Yoursel71/ESP32S3_Carrier/output/render_bottom.png

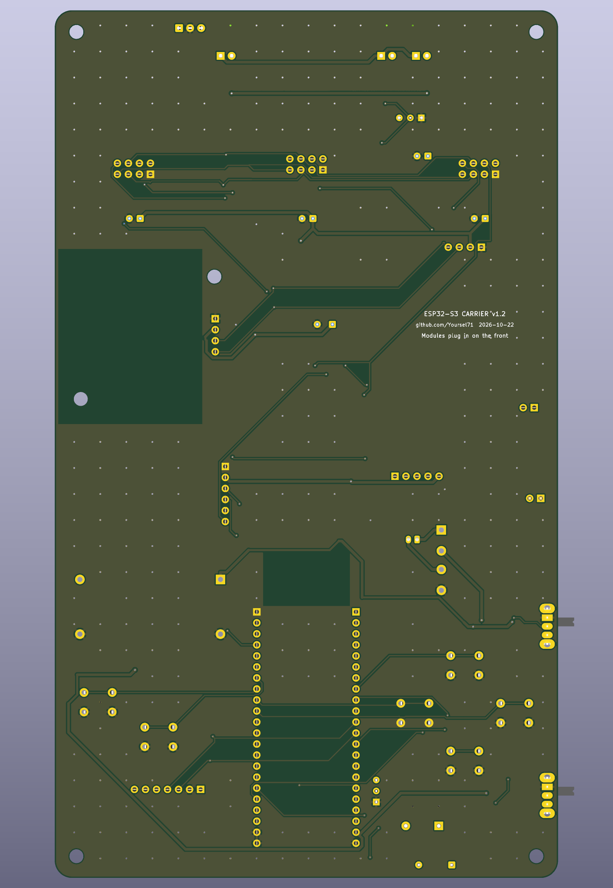
output/render_bottom.png
