Yoursel71/ESP32S3_Carrier/output/render_perspective.png

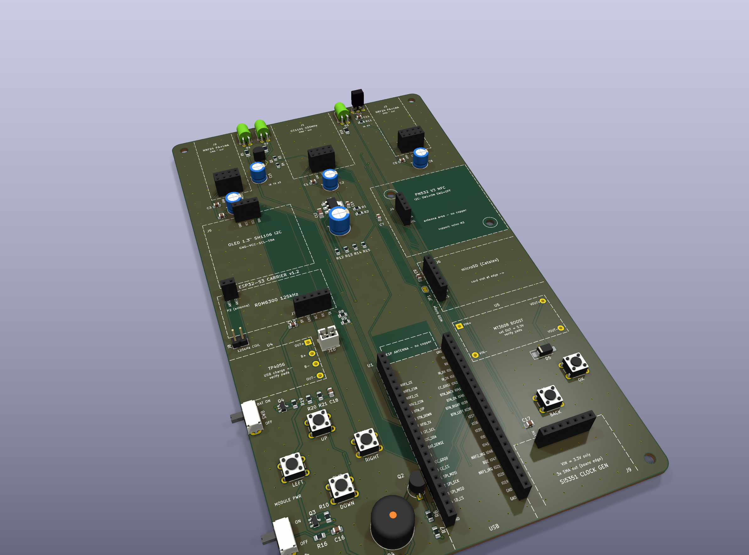
output/render_perspective.png
