Yoursel71/ESP32S3_Carrier/output/BOM.csv

Reference | Value | Footprint | Qty
BZ1 | Passive buzzer | Buzzer_Beeper:Buzzer_12x9.5RM7.6 | 1
C1,C3,C5,C7,C8,C9,C10,C11,C14,C16,C17,C18 | 100nF | Capacitor_SMD:C_0805_2012Metric_Pad1.18x1.45mm_HandSolder | 12
C2,C4,C6,C15 | 100uF | Capacitor_THT:CP_Radial_D6.3mm_P2.50mm | 4
C12 | 10uF | Capacitor_SMD:C_1206_3216Metric_Pad1.33x1.80mm_HandSolder | 1
C13 | 470uF | Capacitor_THT:CP_Radial_D8.0mm_P3.50mm | 1
D1,D2,D3 | IR LED 940nm | LED_THT:LED_D5.0mm_Horizontal_O1.27mm_Z3.0mm | 3
D4 | 1N4148 | Diode_THT:D_DO-35_SOD27_P7.62mm_Horizontal | 1
D5 | SS34 | Diode_SMD:D_SMA_Handsoldering | 1
J1 | CC1101 433MHz SMA | Carrier:CC1101_SMA_2x4_Socket | 1
J2 | NRF24L01+PA+LNA #1 | Carrier:NRF24L01_PA_LNA_Socket | 1
J3 | NRF24L01+PA+LNA #2 | Carrier:NRF24L01_PA_LNA_Socket | 1
J4 | PN532 V3 (I2C) | Carrier:PN532_V3_I2C_Socket | 1
J5 | OLED 1.3in SH1106 I2C | Carrier:OLED_1.3in_I2C_Socket | 1
J6 | Catalex microSD | Carrier:microSD_Catalex_Socket | 1
J7 | RDM6300 125kHz | Carrier:RDM6300_Socket | 1
J8 | 125kHz coil | Connector_PinHeader_2.54mm:PinHeader_1x02_P2.54mm_Vertical | 1
J9 | Si5351 clock gen (3x SMA) | Carrier:Si5351_3SMA_Socket | 1
J10 | 18650 BAT | Connector_JST:JST_PH_B2B-PH-K_1x02_P2.00mm_Vertical | 1
Q1,Q2 | PN2222A | Package_TO_SOT_THT:TO-92_Inline_Wide | 2
Q3,Q4 | AO3401A | Package_TO_SOT_SMD:SOT-23 | 2
R1,R2,R8 | 4.7k | Resistor_SMD:R_0805_2012Metric_Pad1.20x1.40mm_HandSolder | 3
R3 | 220 | Resistor_SMD:R_0805_2012Metric_Pad1.20x1.40mm_HandSolder | 1
R4,R7,R9,R12,R13,R14,R15 | 10k | Resistor_SMD:R_0805_2012Metric_Pad1.20x1.40mm_HandSolder | 7
R5,R17,R18 | 47 | Resistor_SMD:R_1206_3216Metric_Pad1.30x1.75mm_HandSolder | 3
R6 | 1k | Resistor_SMD:R_0805_2012Metric_Pad1.20x1.40mm_HandSolder | 1
R10 | 1M | Resistor_SMD:R_0805_2012Metric_Pad1.20x1.40mm_HandSolder | 1
R11 | 100 | Resistor_SMD:R_0805_2012Metric_Pad1.20x1.40mm_HandSolder | 1
R16,R19,R20,R21 | 100k | Resistor_SMD:R_0805_2012Metric_Pad1.20x1.40mm_HandSolder | 4
SW1 | UP | Button_Switch_THT:SW_PUSH_6mm | 1
SW2 | DOWN | Button_Switch_THT:SW_PUSH_6mm | 1
SW3 | LEFT | Button_Switch_THT:SW_PUSH_6mm | 1
SW4 | RIGHT | Button_Switch_THT:SW_PUSH_6mm | 1
SW5 | OK | Button_Switch_THT:SW_PUSH_6mm | 1
SW6 | BACK | Button_Switch_THT:SW_PUSH_6mm | 1
SW7 | MODULE PWR | Button_Switch_THT:SW_Slide_SPDT_Angled_CK_OS102011MA1Q | 1
SW8 | MAIN PWR | Button_Switch_THT:SW_Slide_SPDT_Angled_CK_OS102011MA1Q | 1
U1 | ESP32-S3-DevKitC-1 N16R8 | Carrier:ESP32-S3-DevKitC-1_Socket | 1
U2 | AMS1117-3.3 | Package_TO_SOT_SMD:SOT-223-3_TabPin2 | 1
U3 | VS1838B | OptoDevice:Vishay_MINICAST-3Pin | 1
U4 | TP4056 module (protected) | Carrier:TP4056_Module_Pads | 1
U5 | MT3608 boost module (set 5.3V) | Carrier:MT3608_Module_Pads | 1
