Yoursel71/ESP32S3_Carrier/output/assembly_1to1.pdf

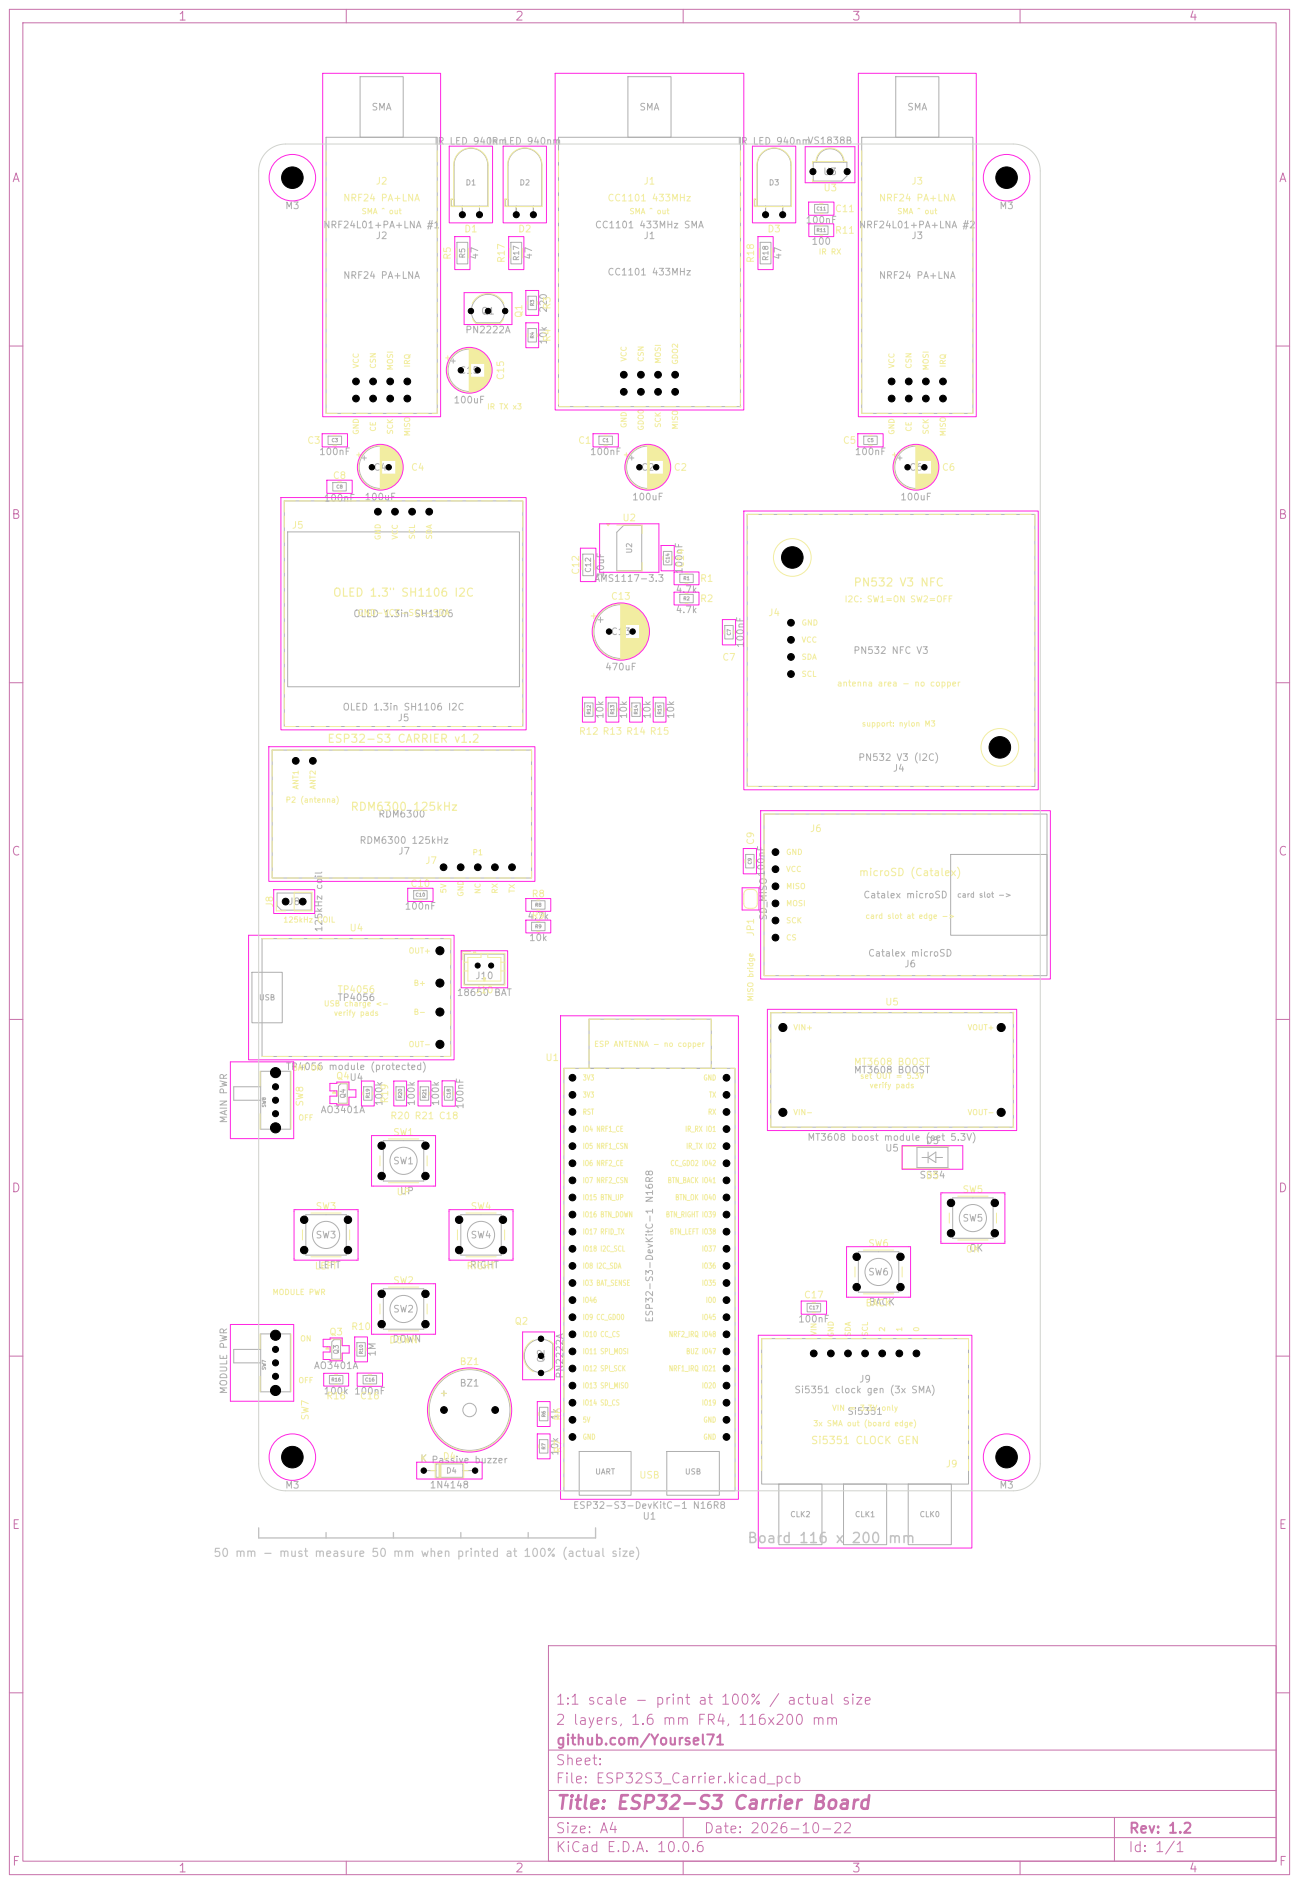
[picture p4: page 1]

IR RX MISO bridge
USB 10k R4 100uF C4

ESP ANTENNA - no copper USB

GND
VCC MISO MOSI SCK

MODULE PWR OFF ON

R16 50 mm - must measure 50 mm when printed at 100% (actual size)

1:1 scale - print at 100% / actual size
2 layers, 1.6 mm FR4, 116x200 mm
github.com/Yoursel71
Sheet:
File: ESP32S3_Carrier.kicad_pcb
Title: ESP32-S3 Carrier Board

Size: A4 | Rev: 1.2
KiCad E.D.A. 10.0.6 | Id: 1/1
