Yoursel71/ESP32S3_Carrier/output/schematic.pdf

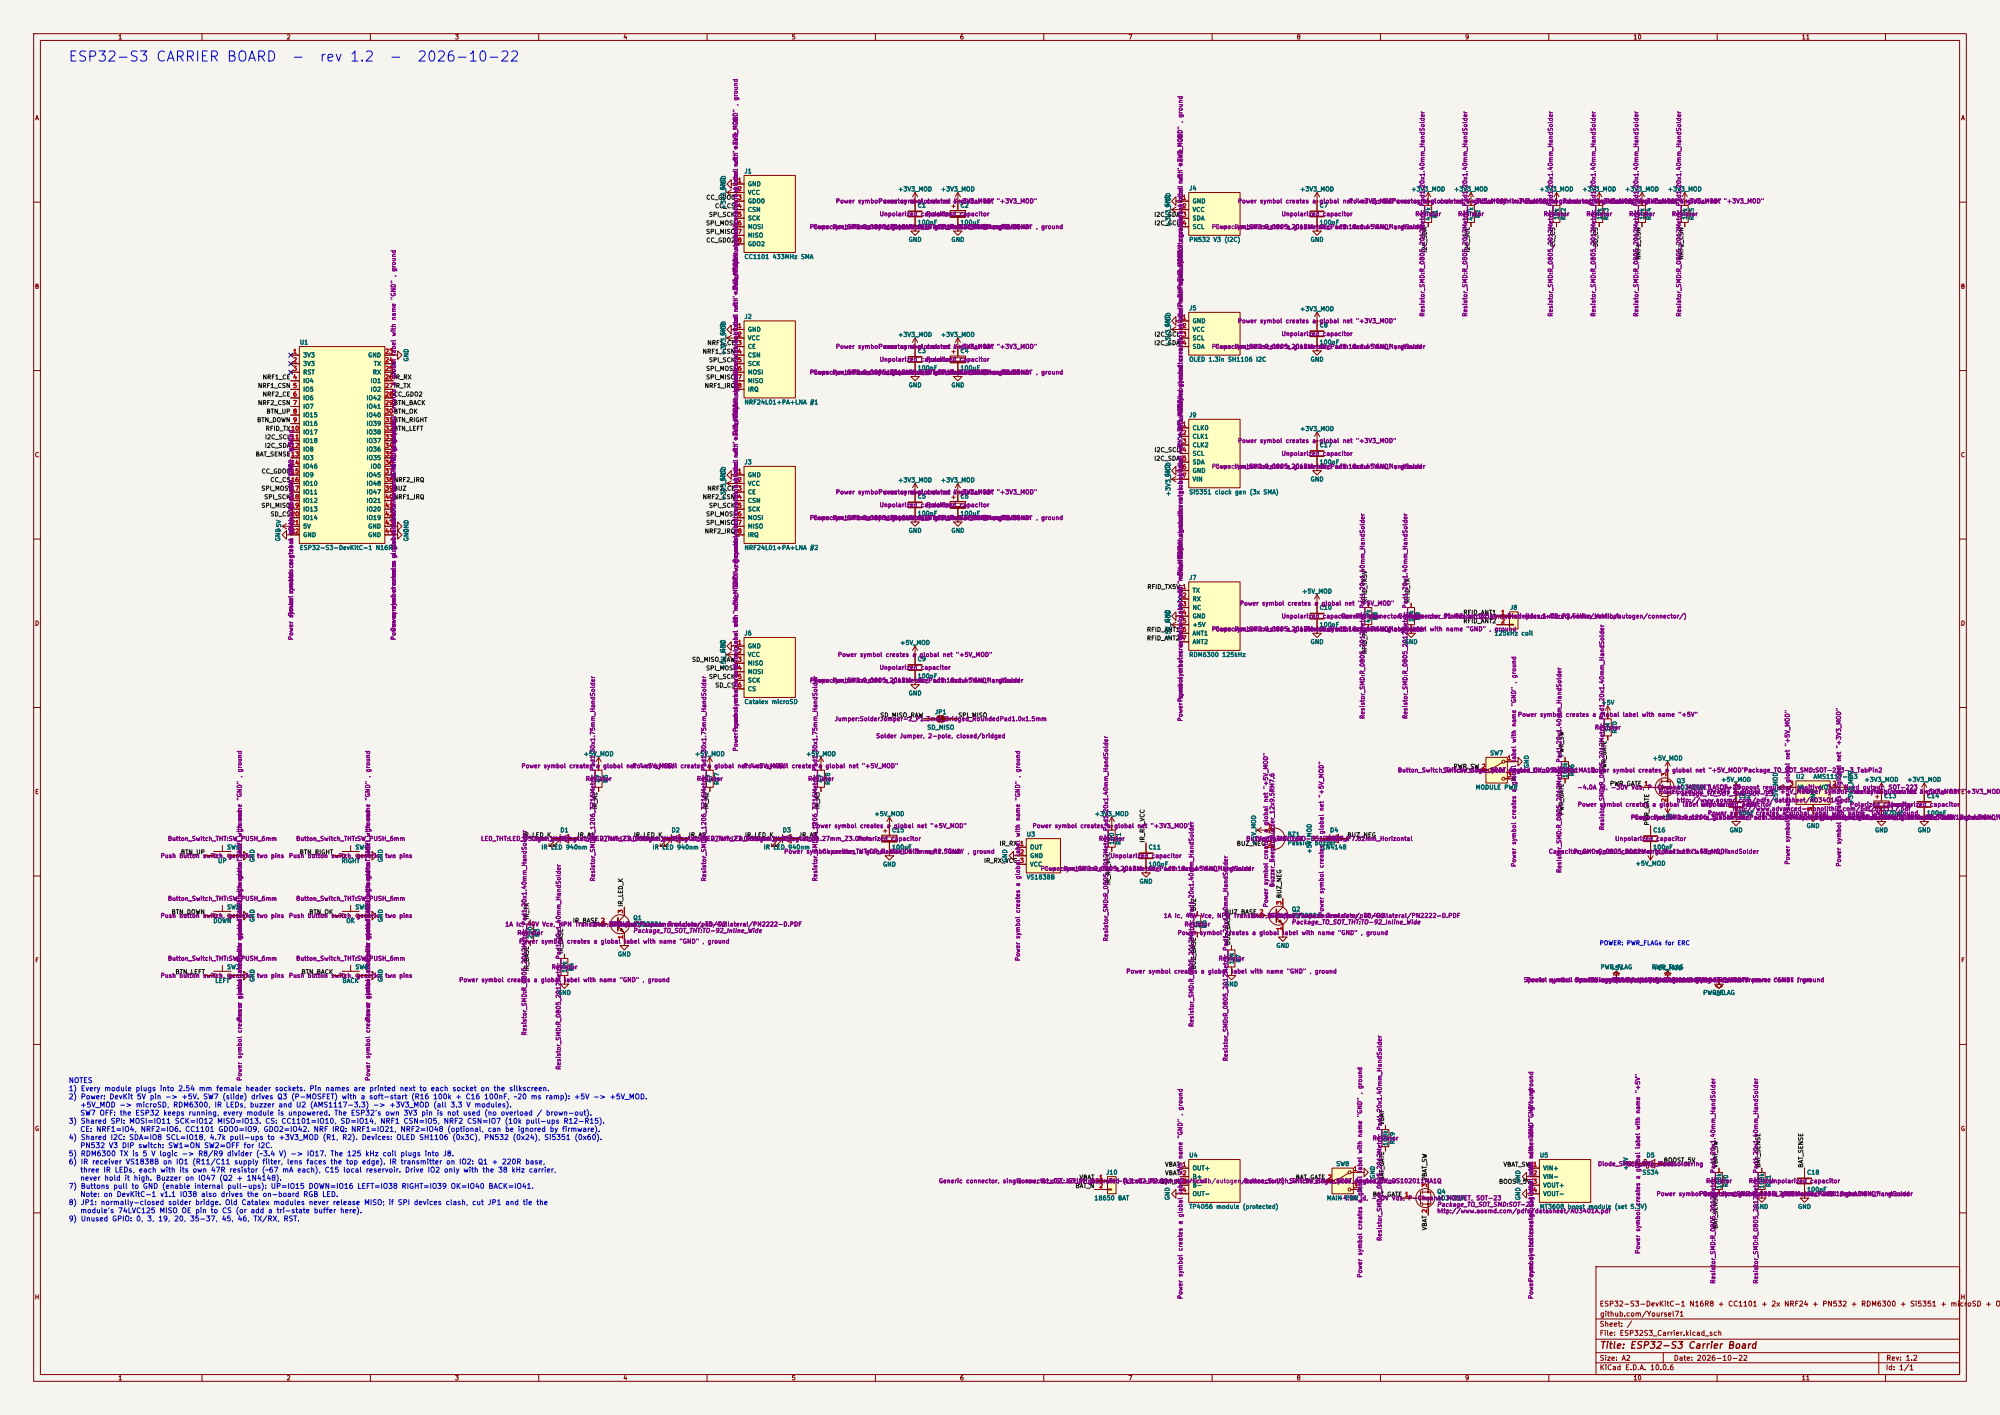
[picture p5: page 1]

IRQ 8 +3V3_MOD Power symbol creates a global net "+3V3_MOD" GND Power symbol creates a global label with name "GND" , ground

J4PN532 V3 (I2C) +3V3_MOD Power symbol creates a global net "+3V3_MOD" GND Power symbol creates a global label with name "GND" , ground GND Power symbol creates a global label with name "GND" , ground

IR_A3 IR_A3 CC_CS CC_GDO0 NRF2_CE SD_CS NRF2_CSN
Push button switch, generic, two pinsGND Power symbol creates a global label with name "GND" , ground 3V3 1

Power symbol creates a global label with name "GND" , ground +3V3_MOD
Power symbol creates a global label with name "GND" , ground C1

Power symbol creates a global net "+3V3_MOD" +3V3_MOD

+3V3_MOD
Power symbol creates a global net "+3V3_MOD"

VCC 2
SDA 3
Power symbol creates a global label with name "GND" , ground GND Power symbol creates a global label with name "GND" , ground
SCL 4

100nF Capacitor_SMD:C_0805_2012Metric_Pad1.18x1.45mm_HandSolder
Power symbol creates a global label with name "GND" , ground C3

Power symbol creates a global label with name "GND" , ground C8

3 GND Power symbol creates a global label with name "GND" , ground U1

J5OLED 1.3in SH1106 I2C
GND 1
SCL 3
SDA 4

I2C_SDA SPI_MISO

Power symbol creates a global label with name "GND" , ground C4

Power symbol creates a global label with name "GND" , ground GND

Si5351 clock gen (3x SMA) GND Power symbol creates a global label with name "GND" , ground +3V3_MOD Power symbol creates a global net "+3V3_MOD"

Power symbol creates a global label with name "GND" , ground

Power symbol creates a global label with name "GND" , ground 1

Power symbol creates a global net "+5V_MOD" GND

Solder Jumper, 2-pole, closed/bridged R18 47 Resistor_SMD:R_1206_3216Metric_Pad1.30x1.75mm_HandSolder Resistor D3

http://www.aosmd.com/pdfs/datasheet/AO3401A.pdf -4.0A Id, -30V Vds, P-Channel MOSFET, SOT-23 +5V_MOD
Power symbol creates a global net "+5V_MOD" C16

Power symbol creates a global net "+5V_MOD"

Power symbol creates a global net "+5V_MOD"D2

Power symbol creates a global net "+5V_MOD"C15

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

Power symbol creates a global label with name "GND" , ground Q3

Unpolarized capacitor +5V_MOD
Power symbol creates a global label with name "GND" , ground C13

Button_Switch_THT:SW_PUSH_6mm
Push button switch, generic, two pins SW1 UP
BTN_UP

SW4 RIGHT Button_Switch_THT:SW_PUSH_6mm
BTN_RIGHT
Push button switch, generic, two pins SW5 OK

IR LED 940nm

Push button switch, generic, two pins SW2 DOWN

3 Q2PN2222A Package_TO_SOT_THT:TO-92_Inline_Wide 1A Ic, 40V Vce, NPN Transistor, 1=E 2=B NPN General https://www.onsemi.com/pub/Collateral/PN2222-D.PDF 3=CPurpose Transistor, TO-92

3 Q1PN2222A Package_TO_SOT_THT:TO-92_Inline_Wide 1A Ic, 40V Vce, NPN Transistor, 1=E 2=B NPN General https://www.onsemi.com/pub/Collateral/PN2222-D.PDF 3=CPurpose Transistor, TO-92 GND

Power symbol creates a global label with name "GND" , ground SW3

Power symbol creates a global label with name "GND" , ground +5V Power symbol creates a global label with name "+5V" PWR_FLAG
Special symbol for telling ERC where power comes from

Power symbol creates a global net "+5V_MOD" PWR_FLAG
SS34 Diode_SMD:D_SMA_Handsoldering Schottky diode +5V_MOD

NOTES
1) Every module plugs into 2.54 mm female header sockets. Pin names are printed next to each socket on the silkscreen.
2) Power: DevKit 5V pin -> +5V. SW7 (slide) drives Q3 (P-MOSFET) with a soft-start (R16 100k + C16 100nF, ~20 ms ramp): +5V -> +5V_MOD.
+5V_MOD -> microSD, RDM6300, IR LEDs, buzzer and U2 (AMS1117-3.3) -> +3V3_MOD (all 3.3 V modules).
SW7 OFF: the ESP32 keeps running, every module is unpowered. The ESP32's own 3V3 pin is not used (no overload / brown-out). 3) Shared SPI: MOSI=IO11 SCK=IO12 MISO=IO13. CS: CC1101=IO10, SD=IO14, NRF1 CSN=IO5, NRF2 CSN=IO7 (10k pull-ups R12-R15).

CE: NRF1=IO4, NRF2=IO6. CC1101 GDO0=IO9, GDO2=IO42. NRF IRQ: NRF1=IO21, NRF2=IO48 (optional, can be ignored by firmware). 4) Shared I2C: SDA=IO8 SCL=IO18, 4.7k pull-ups to +3V3_MOD (R1, R2). Devices: OLED SH1106 (0x3C), PN532 (0x24), Si5351 (0x60).

PN532 V3 DIP switch: SW1=ON SW2=OFF for I2C.
5) RDM6300 TX is 5 V logic -> R8/R9 divider (~3.4 V) -> IO17. The 125 kHz coil plugs into J8.
6) IR receiver VS1838B on IO1 (R11/C11 supply filter, lens faces the top edge). IR transmitter on IO2: Q1 + 220R base,
three IR LEDs, each with its own 47R resistor (~67 mA each), C15 local reservoir. Drive IO2 only with the 38 kHz carrier, never hold it high. Buzzer on IO47 (Q2 + 1N4148). 7) Buttons pull to GND (enable internal pull-ups): UP=IO15 DOWN=IO16 LEFT=IO38 RIGHT=IO39 OK=IO40 BACK=IO41.

2 3 U5MT3608 boost module (set 5.3V) VIN+

18650 BAT Generic connector, single Connector_JST:JST_PH_B2B-PH-K_1x02_P2.00mm_Vertical row, 01x02, script generated (kicad-library-utils/schlib/autogen/connector/) 1

Power symbol creates a global label with name "GND" , ground C18

Note: on DevKitC-1 v1.1 IO38 also drives the on-board RGB LED.
8) JP1: normally-closed solder bridge. Old Catalex modules never release MISO; if SPI devices clash, cut JP1 and tie the

Size: A2 | Rev: 1.2
KiCad E.D.A. 10.0.6 | Id: 1/1
