Yoursel71/ESP32S3_Carrier/output/copper_layers_1to1.pdf

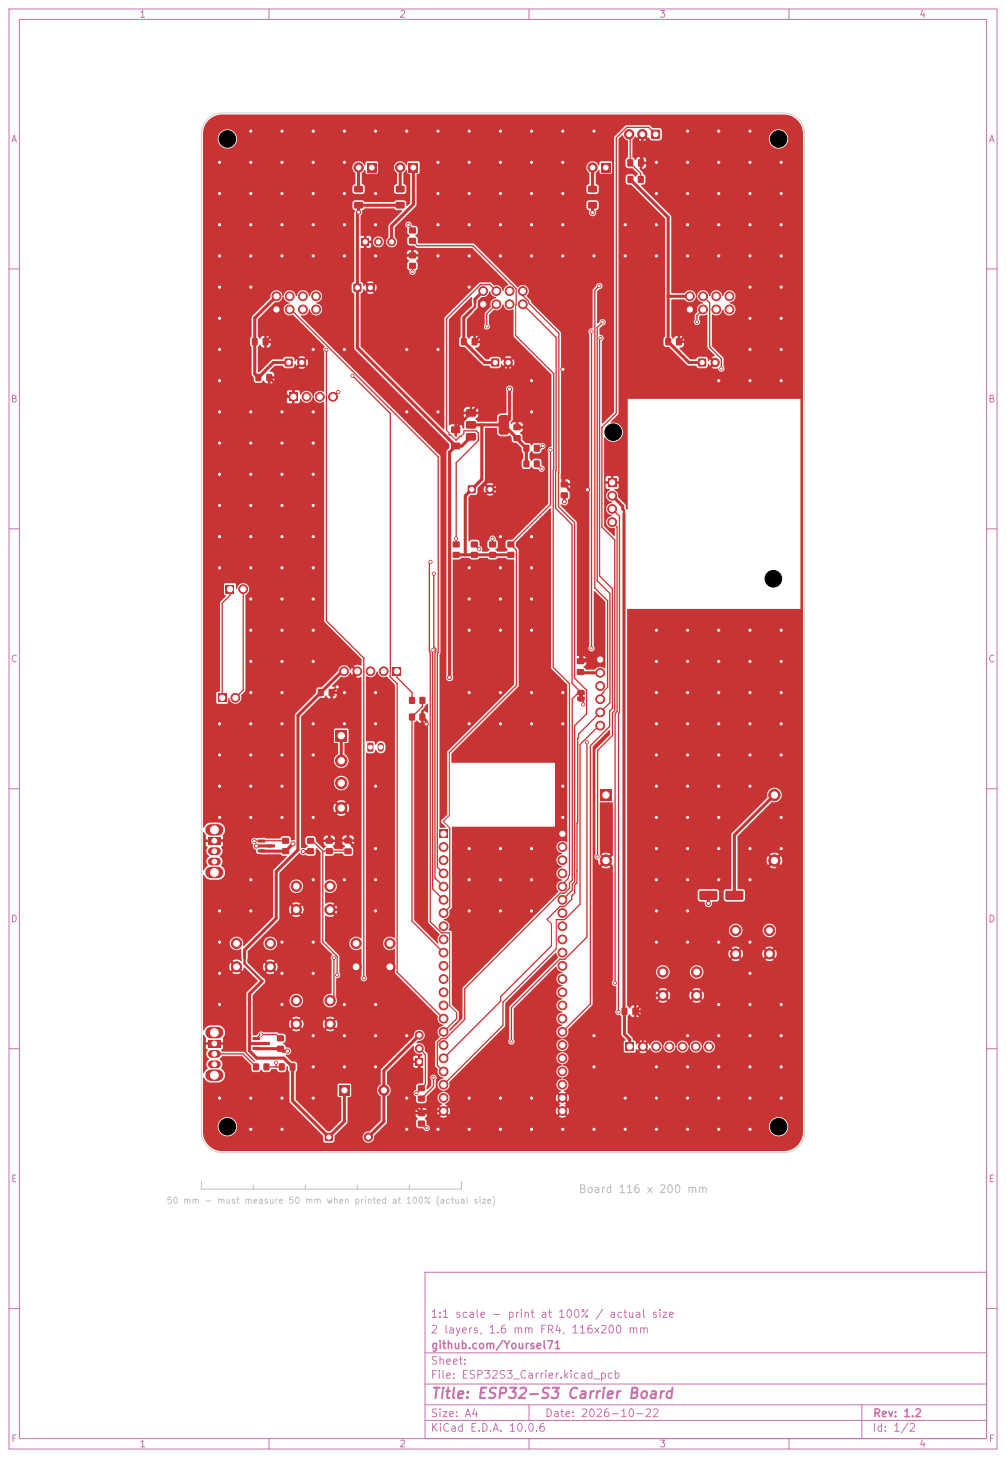
[picture p6: page 1]

50 mm - must measure 50 mm when printed at 100% (actual size)

1:1 scale - print at 100% / actual size
2 layers, 1.6 mm FR4, 116x200 mm
github.com/Yoursel71
Sheet:
File: ESP32S3_Carrier.kicad_pcb
Title: ESP32-S3 Carrier Board

Size: A4 | Rev: 1.2 | F Date: 2026-10-22
KiCad E.D.A. 10.0.6 | Id: 1/2

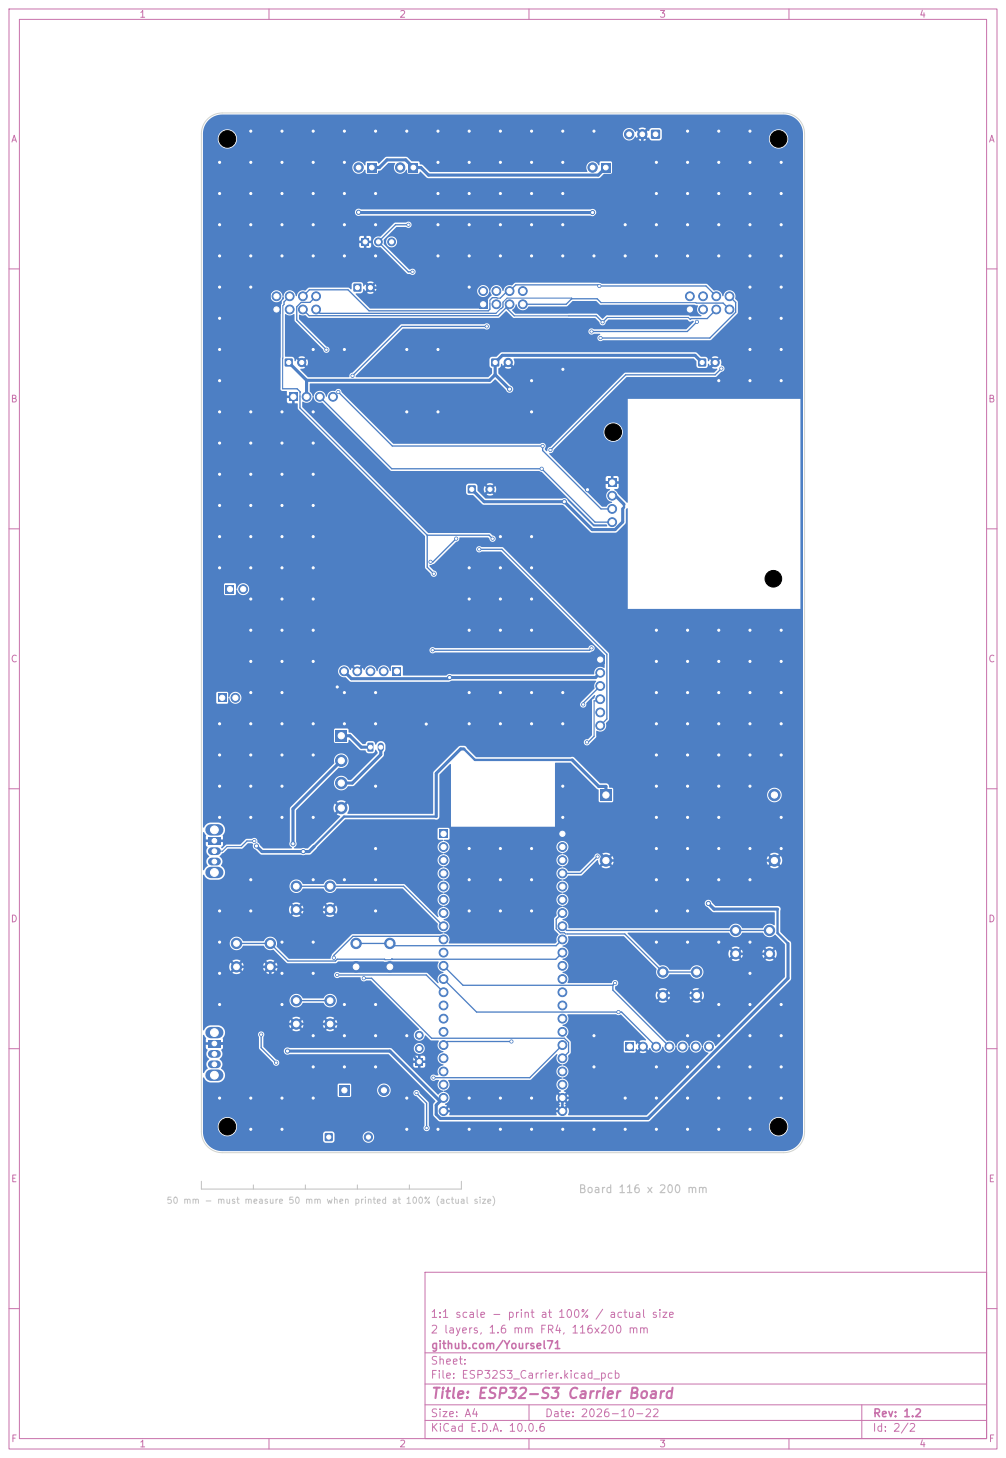
[picture p7: page 2]

50 mm - must measure 50 mm when printed at 100% (actual size)

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

Size: A4 | Rev: 1.2 | F Date: 2026-10-22
KiCad E.D.A. 10.0.6 | Id: 2/2
