Yoursel71/ESP32S3_Carrier/(list of files, drawings)

Other design files:
scripts/_route.dsn
