Yoursel71/ESP32S3_Carrier/ESP32S3_Carrier.kicad_pcb

## KiCad design ESP32S3_Carrier.kicad_pcb (2026-10-22)

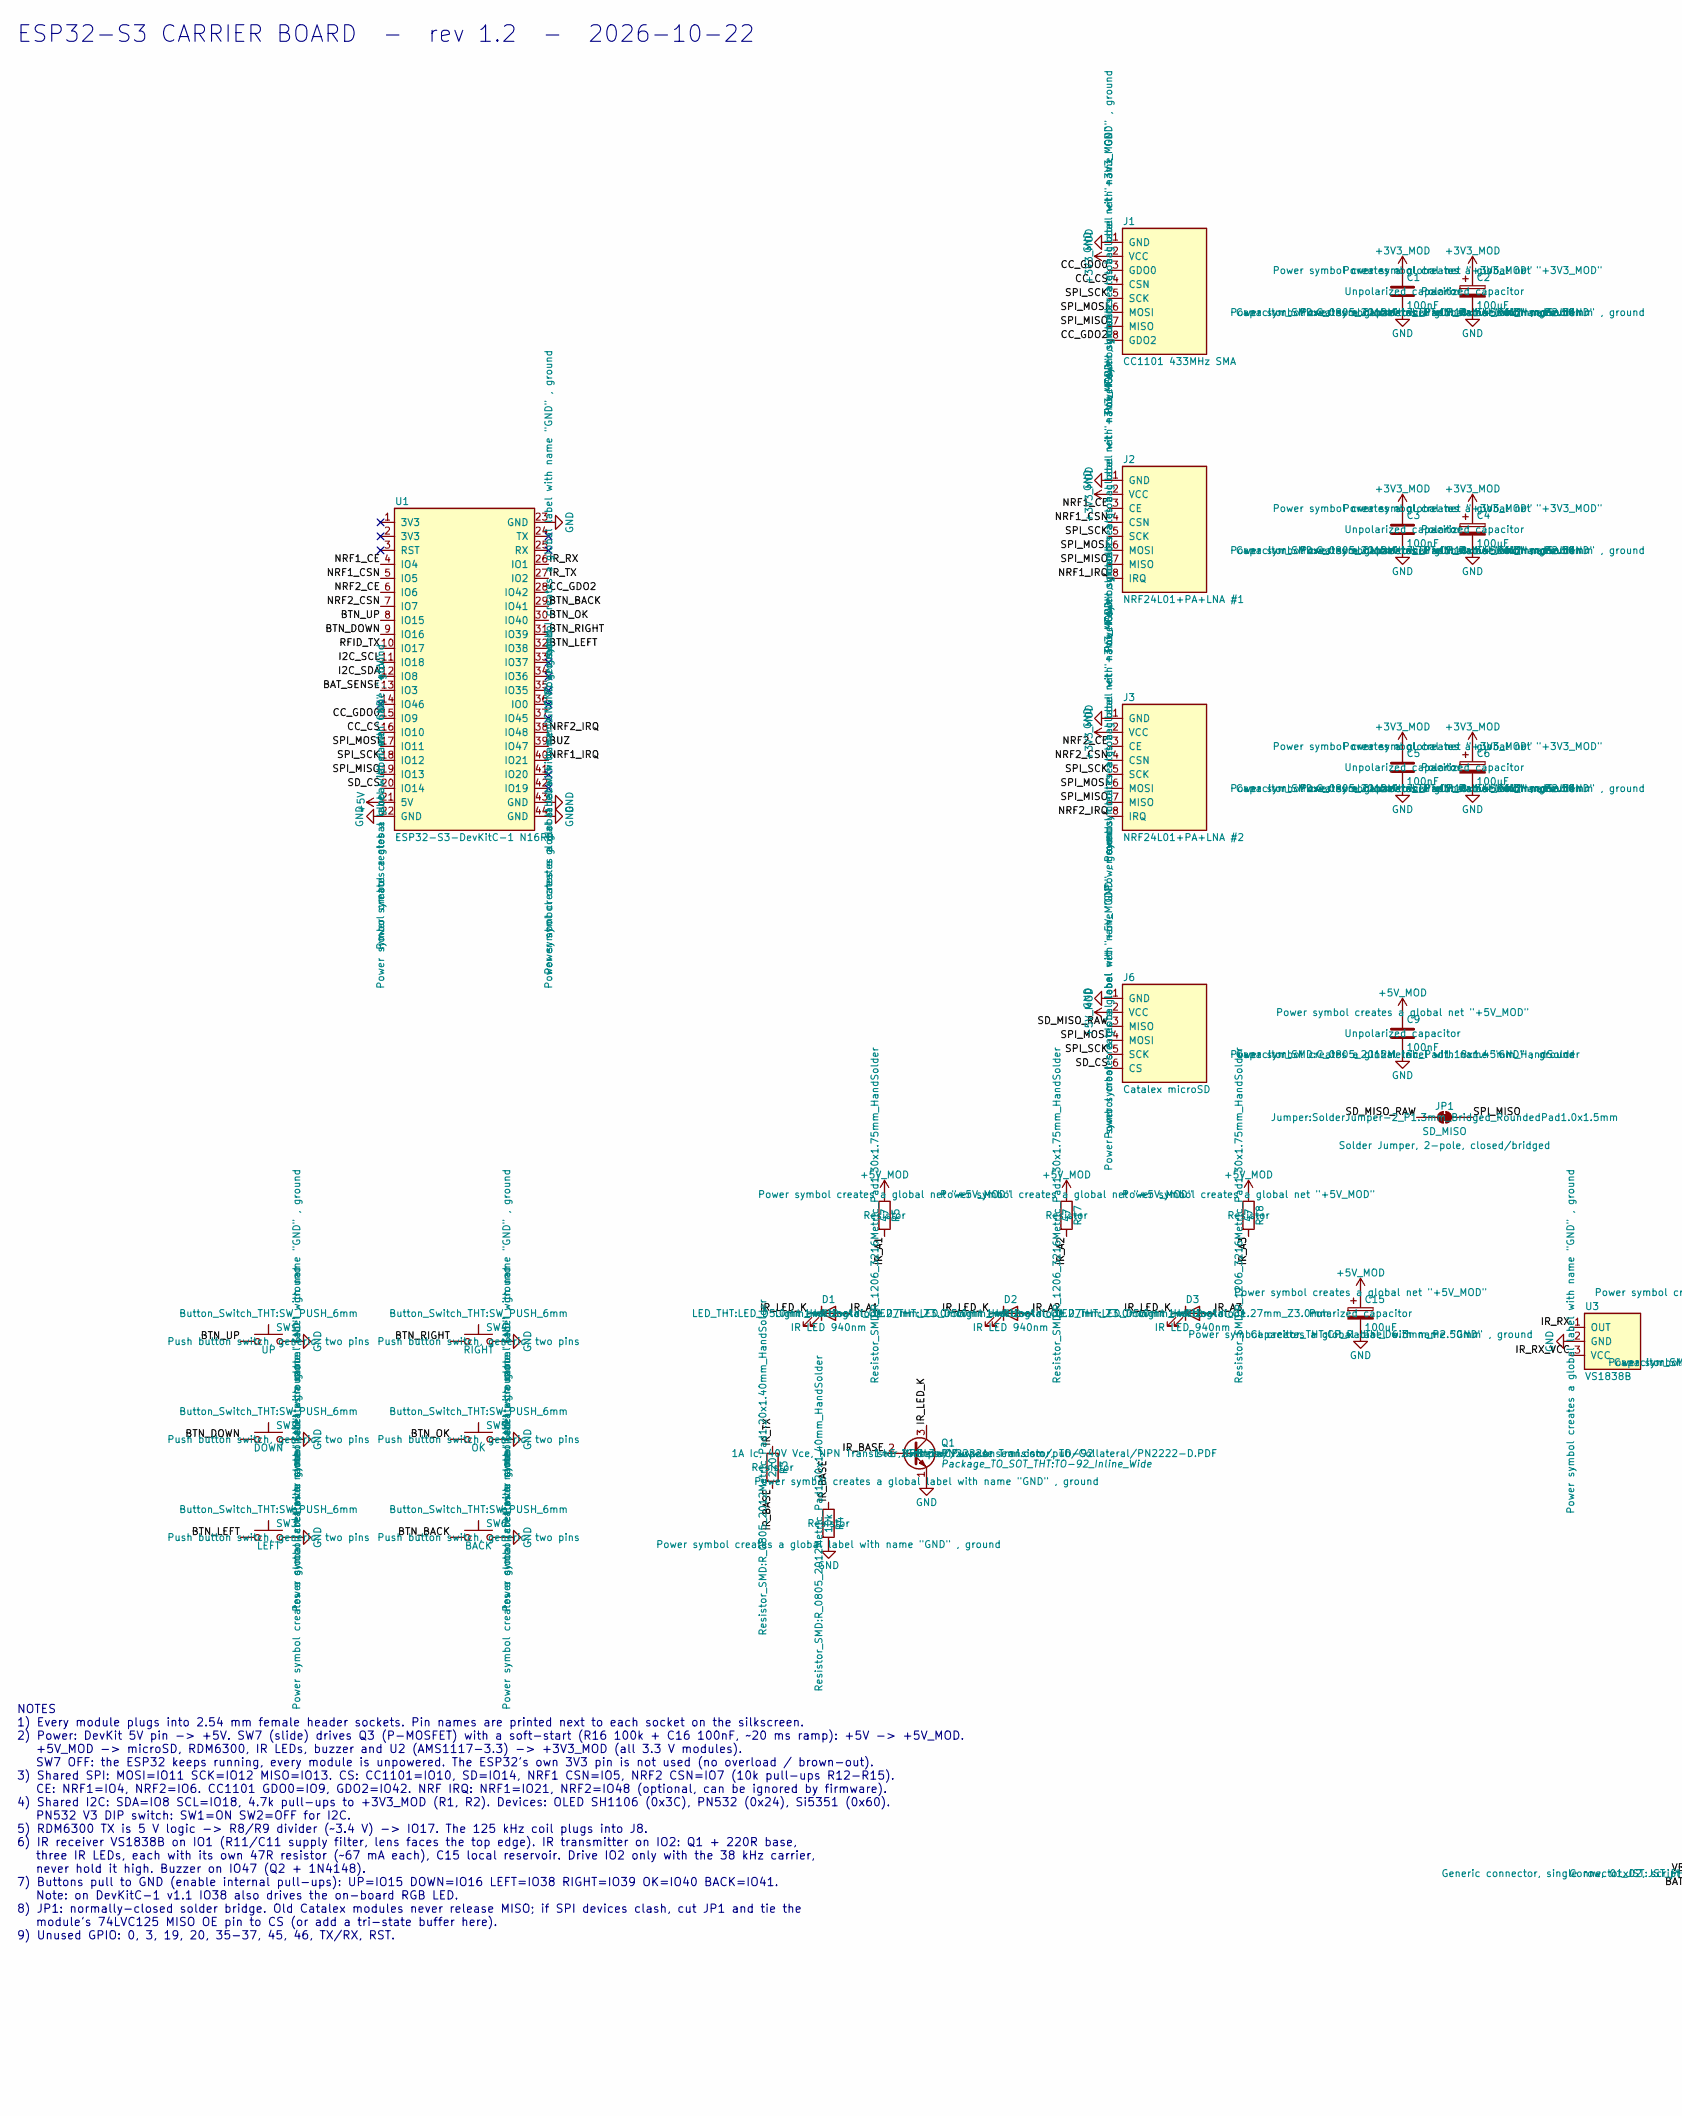
[picture p8: schematic ESP32S3_Carrier.kicad_sch, ESP32-S3 Carrier Board, part in row 1, column 1]

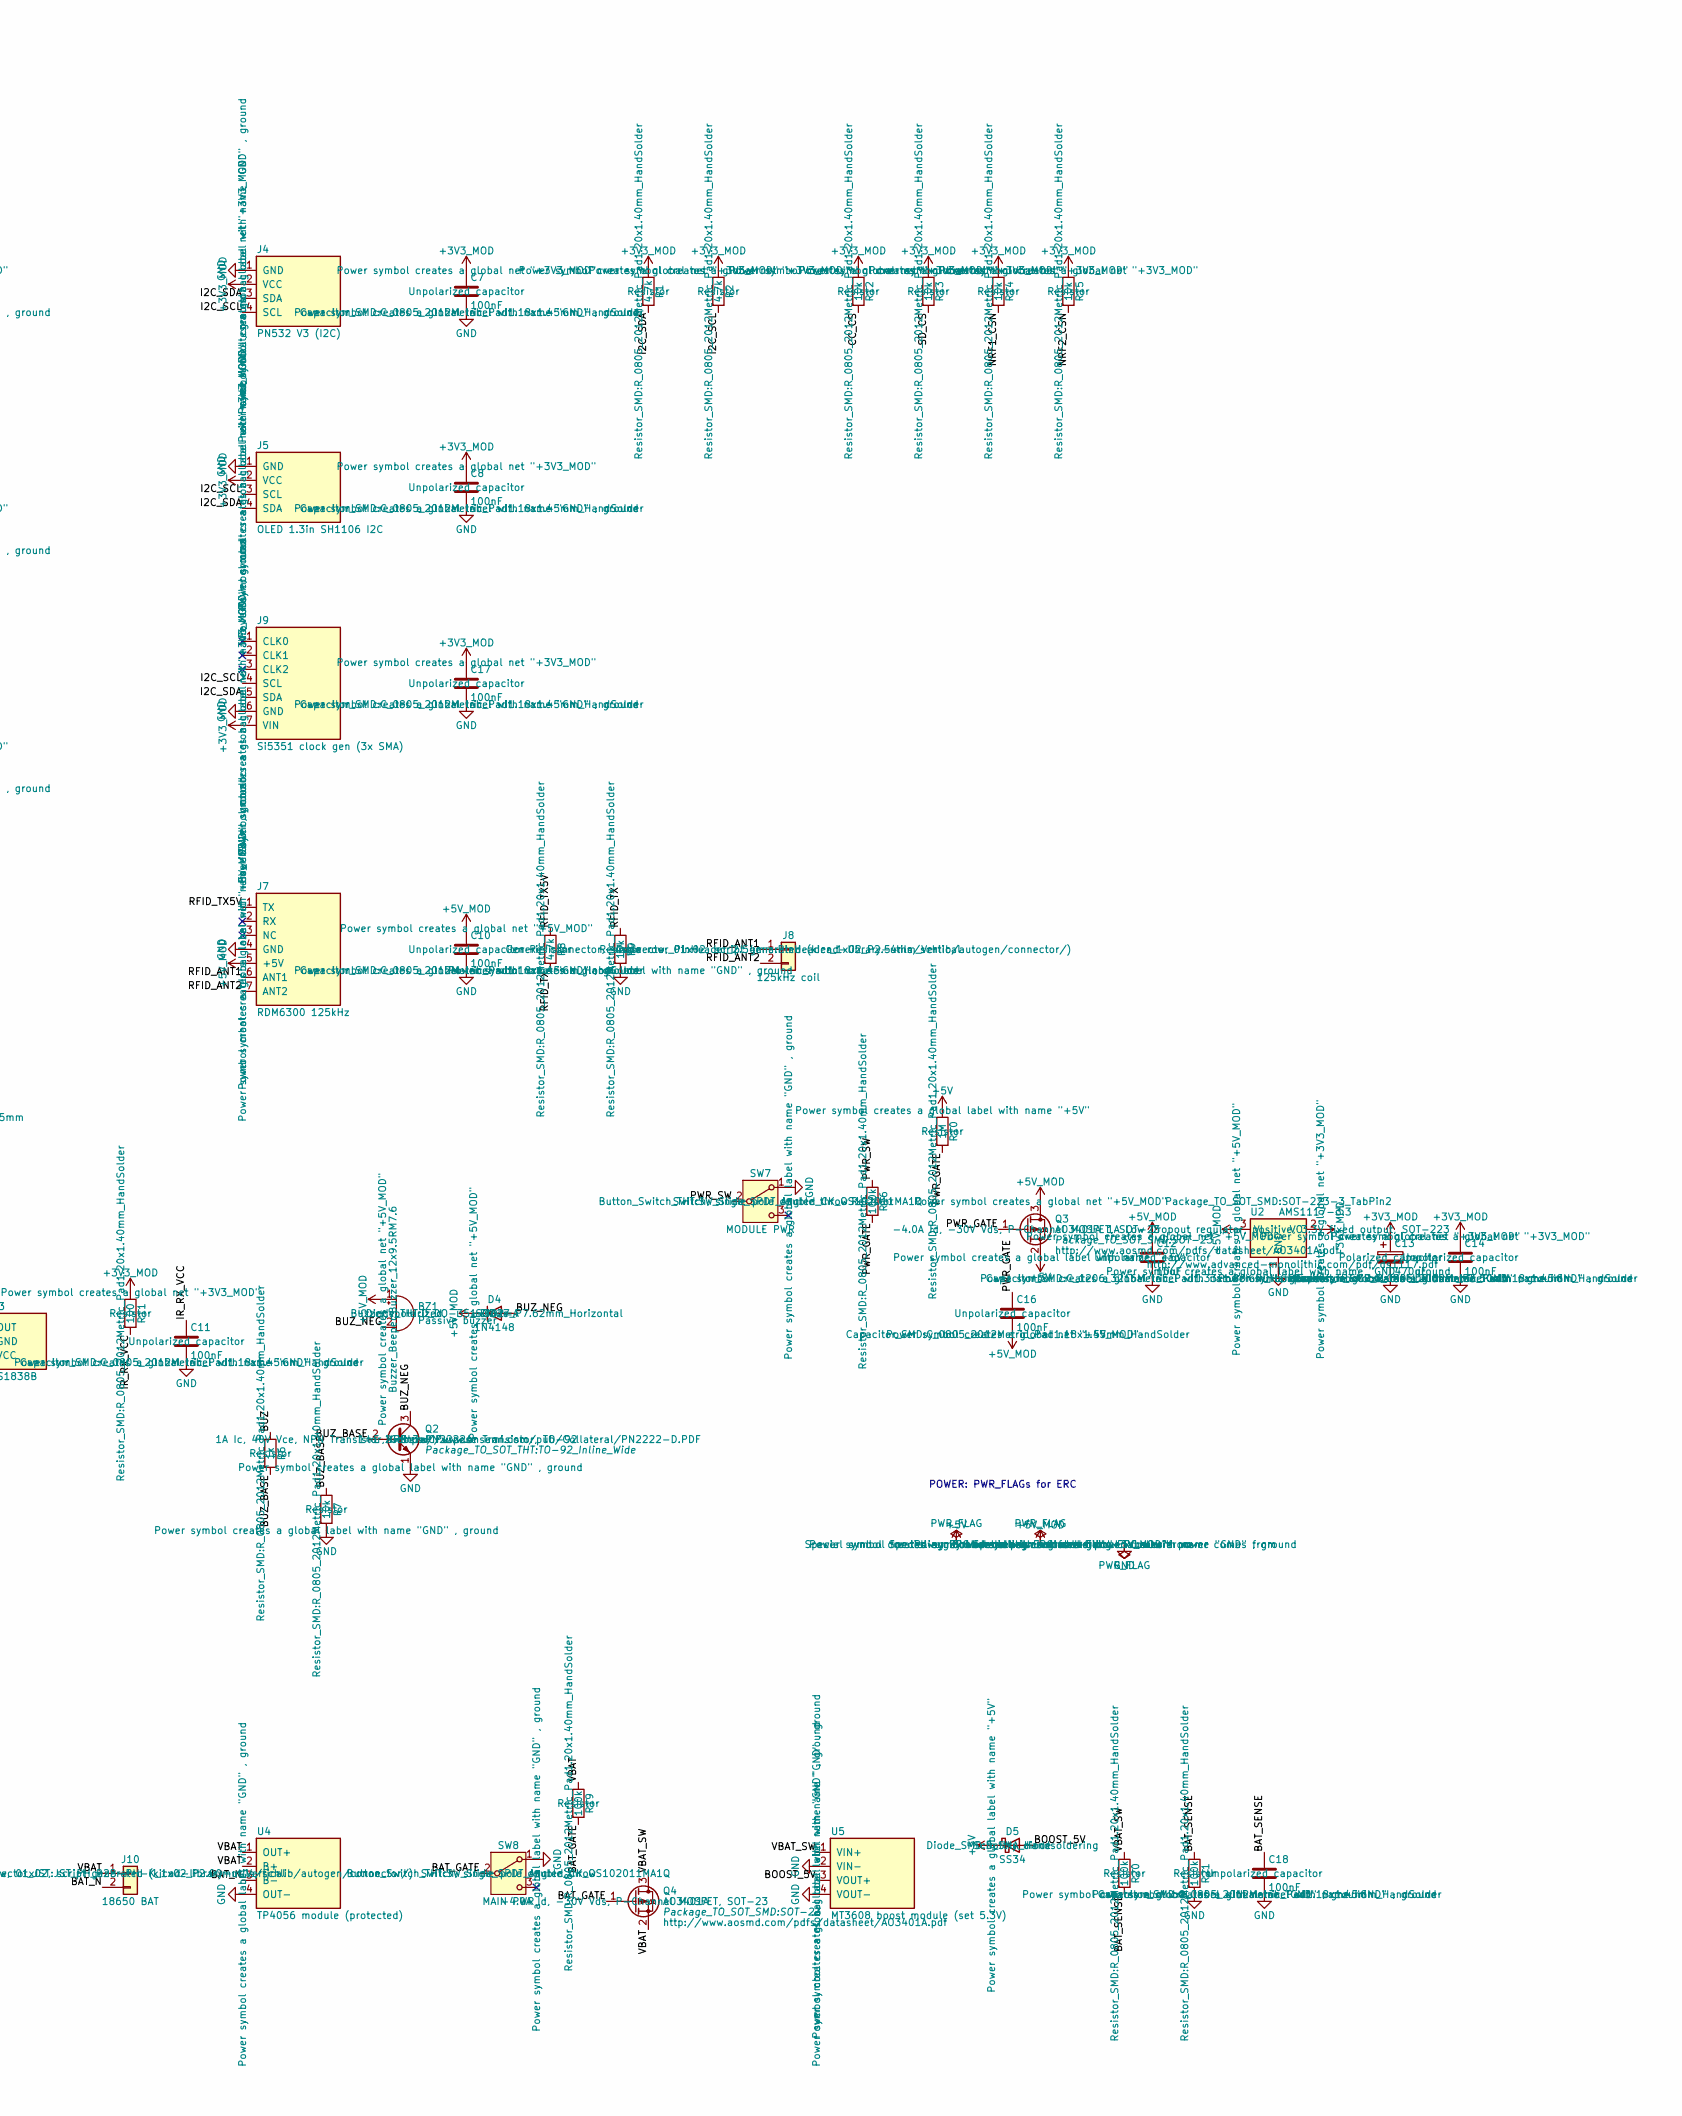
[picture p9: schematic ESP32S3_Carrier.kicad_sch, ESP32-S3 Carrier Board, part in row 1, column 2]

Parts:
BZ1: Passive buzzer; Buzzer_12x9.5RM7.6
C1, C3, C5, C7, C8, C9, C10, C11, C14, C16, C17, C18: 100nF; C_0805_2012Metric_Pad1.18x1.45mm_HandSolder
C2, C4, C6, C15: 100uF; CP_Radial_D6.3mm_P2.50mm
C12: 10uF; C_1206_3216Metric_Pad1.33x1.80mm_HandSolder
C13: 470uF; CP_Radial_D8.0mm_P3.50mm
D1, D2, D3: IR LED 940nm; LED_D5.0mm_Horizontal_O1.27mm_Z3.0mm
D4: 1N4148; D_DO-35_SOD27_P7.62mm_Horizontal
D5: SS34; D_SMA_Handsoldering
J1: CC1101 433MHz SMA; CC1101_SMA_2x4_Socket
J2: NRF24L01+PA+LNA #1; NRF24L01_PA_LNA_Socket
J3: NRF24L01+PA+LNA #2; NRF24L01_PA_LNA_Socket
J4: PN532 V3 (I2C); PN532_V3_I2C_Socket
J5: OLED 1.3in SH1106 I2C; OLED_1.3in_I2C_Socket
J6: Catalex microSD; microSD_Catalex_Socket
J7: RDM6300 125kHz; RDM6300_Socket
J8: 125kHz coil; PinHeader_1x02_P2.54mm_Vertical
J9: Si5351 clock gen (3x SMA); Si5351_3SMA_Socket
J10: 18650 BAT; JST_PH_B2B-PH-K_1x02_P2.00mm_Vertical
JP1: SD_MISO; SolderJumper-2_P1.3mm_Bridged_RoundedPad1.0x1.5mm
Q1, Q2: PN2222A; TO-92_Inline_Wide
Q3, Q4: AO3401A; SOT-23
R1, R2, R8: 4.7k; R_0805_2012Metric_Pad1.20x1.40mm_HandSolder
R3: 220; R_0805_2012Metric_Pad1.20x1.40mm_HandSolder
R4, R7, R9, R12, R13, R14, R15: 10k; R_0805_2012Metric_Pad1.20x1.40mm_HandSolder
R5, R17, R18: 47; R_1206_3216Metric_Pad1.30x1.75mm_HandSolder
R6: 1k; R_0805_2012Metric_Pad1.20x1.40mm_HandSolder
R10: 1M; R_0805_2012Metric_Pad1.20x1.40mm_HandSolder
R11: 100; R_0805_2012Metric_Pad1.20x1.40mm_HandSolder
R16, R19, R20, R21: 100k; R_0805_2012Metric_Pad1.20x1.40mm_HandSolder
SW1: UP; SW_PUSH_6mm
SW2: DOWN; SW_PUSH_6mm
SW3: LEFT; SW_PUSH_6mm
SW4: RIGHT; SW_PUSH_6mm
SW5: OK; SW_PUSH_6mm
SW6: BACK; SW_PUSH_6mm
SW7: MODULE PWR; SW_Slide_SPDT_Angled_CK_OS102011MA1Q
SW8: MAIN PWR; SW_Slide_SPDT_Angled_CK_OS102011MA1Q
U1: ESP32-S3-DevKitC-1 N16R8; ESP32-S3-DevKitC-1_Socket
U2: AMS1117-3.3; SOT-223-3_TabPin2
U3: VS1838B; Vishay_MINICAST-3Pin
U4: TP4056 module (protected); TP4056_Module_Pads
U5: MT3608 boost module (set 5.3V); MT3608_Module_Pads

Connections:
+3V3_MOD: C1.1, C2.1, C3.1, C4.1, C5.1, C6.1, C7.1, C8.1, C13.1, C14.1, C17.1, J1.2 (VCC), J2.2 (VCC), J3.2 (VCC), J4.2 (VCC), J5.2 (VCC), J9.7 (VIN), R1.1, R2.1, R11.1, R12.1, R13.1, R14.1, R15.1, U2.2 (VO)
+5V: D5.1 (K), Q3.2 (S), R10.1, U1.21 (5V)
+5V_MOD: BZ1.1 (+), C9.1, C10.1, C12.1, C15.1, C16.2, D4.1 (K), J6.2 (VCC), J7.5 (+5V), Q3.3 (D), R5.1, R17.1, R18.1, U2.3 (VI)
/BAT_GATE: Q4.1 (G), R19.2, SW8.2 (B)
/BAT_N: J10.2, U4.3 (B-)
/BAT_SENSE: C18.1, R20.2, R21.1, U1.13 (IO3)
/BOOST_5V: D5.2 (A), U5.3 (VOUT+)
/BTN_BACK: SW6.1, U1.29 (IO41)
/BTN_DOWN: SW2.1, U1.9 (IO16)
/BTN_LEFT: SW3.1, U1.32 (IO38)
/BTN_OK: SW5.1, U1.30 (IO40)
/BTN_RIGHT: SW4.1, U1.31 (IO39)
/BTN_UP: SW1.1, U1.8 (IO15)
/BUZ: R6.1, U1.39 (IO47)
/BUZ_BASE: Q2.2 (B), R6.2, R7.1
/BUZ_NEG: BZ1.2 (-), D4.2 (A), Q2.3 (C)
/CC_CS: J1.4 (CSN), R12.2, U1.16 (IO10)
/CC_GDO0: J1.3 (GDO0), U1.15 (IO9)
/CC_GDO2: J1.8 (GDO2), U1.28 (IO42)
/I2C_SCL: J4.4 (SCL), J5.3 (SCL), J9.4 (SCL), R2.2, U1.11 (IO18)
/I2C_SDA: J4.3 (SDA), J5.4 (SDA), J9.5 (SDA), R1.2, U1.12 (IO8)
/IR_A1: D1.2 (A), R5.2
/IR_A2: D2.2 (A), R17.2
/IR_A3: D3.2 (A), R18.2
/IR_BASE: Q1.2 (B), R3.2, R4.1
/IR_LED_K: D1.1 (K), D2.1 (K), D3.1 (K), Q1.3 (C)
/IR_RX: U1.26 (IO1), U3.1 (OUT)
/IR_RX_VCC: C11.1, R11.2, U3.3 (VCC)
/IR_TX: R3.1, U1.27 (IO2)
/NRF1_CE: J2.3 (CE), U1.4 (IO4)
/NRF1_CSN: J2.4 (CSN), R14.2, U1.5 (IO5)
/NRF1_IRQ: J2.8 (IRQ), U1.40 (IO21)
/NRF2_CE: J3.3 (CE), U1.6 (IO6)
/NRF2_CSN: J3.4 (CSN), R15.2, U1.7 (IO7)
/NRF2_IRQ: J3.8 (IRQ), U1.38 (IO48)
/PWR_GATE: C16.1, Q3.1 (G), R10.2, R16.2
/PWR_SW: R16.1, SW7.2 (B)
/RFID_ANT1: J7.6 (ANT1), J8.1
/RFID_ANT2: J7.7 (ANT2), J8.2
/RFID_TX: R8.2, R9.1, U1.10 (IO17)
/RFID_TX5V: J7.1 (TX), R8.1
/SD_CS: J6.6 (CS), R13.2, U1.20 (IO14)
/SD_MISO_RAW: J6.3 (MISO), JP1.1 (A)
/SPI_MISO: J1.7 (MISO), J2.7 (MISO), J3.7 (MISO), JP1.2 (B), U1.19 (IO13)
/SPI_MOSI: J1.6 (MOSI), J2.6 (MOSI), J3.6 (MOSI), J6.4 (MOSI), U1.17 (IO11)
/SPI_SCK: J1.5 (SCK), J2.5 (SCK), J3.5 (SCK), J6.5 (SCK), U1.18 (IO12)
/VBAT: J10.1, Q4.2 (S), R19.1, U4.1 (OUT+), U4.2 (B+)
/VBAT_SW: Q4.3 (D), R20.1, U5.1 (VIN+)
GND: C1.2, C2.2, C3.2, C4.2, C5.2, C6.2, C7.2, C8.2, C9.2, C10.2, C11.2, C12.2, C13.2, C14.2, C15.2, C17.2, C18.2, J1.1 (GND), J2.1 (GND), J3.1 (GND), J4.1 (GND), J5.1 (GND), J6.1 (GND), J7.4 (GND), J9.6 (GND), Q1.1 (E), Q2.1 (E), R4.2, R7.2, R9.2, R21.2, SW1.2, SW2.2, SW3.2, SW4.2, SW5.2, SW6.2, SW7.1 (A), SW8.1 (A), U1.22 (GND), U1.23 (GND), U1.43 (GND), U1.44 (GND), U2.1 (GND), U3.2 (GND), U4.4 (OUT-), U5.2 (VIN-), U5.4 (VOUT-)

Notes on the sheet:
ESP32-S3 CARRIER BOARD - rev 1.2 - 2026-10-22
NOTES 1) Every module plugs into 2.54 mm female header sockets. Pin names are printed next to each socket on the silkscreen. 2) Power: DevKit 5V pin -> +5V. SW7 (slide) drives Q3 (P-MOSFET) with a soft-start (R16 100k + C16 100nF, ~20 ms ramp): +5V -> +5V_MOD. +5V_MOD -> microSD, RDM6300, IR LEDs, 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
POWER: PWR_FLAGs for ERC

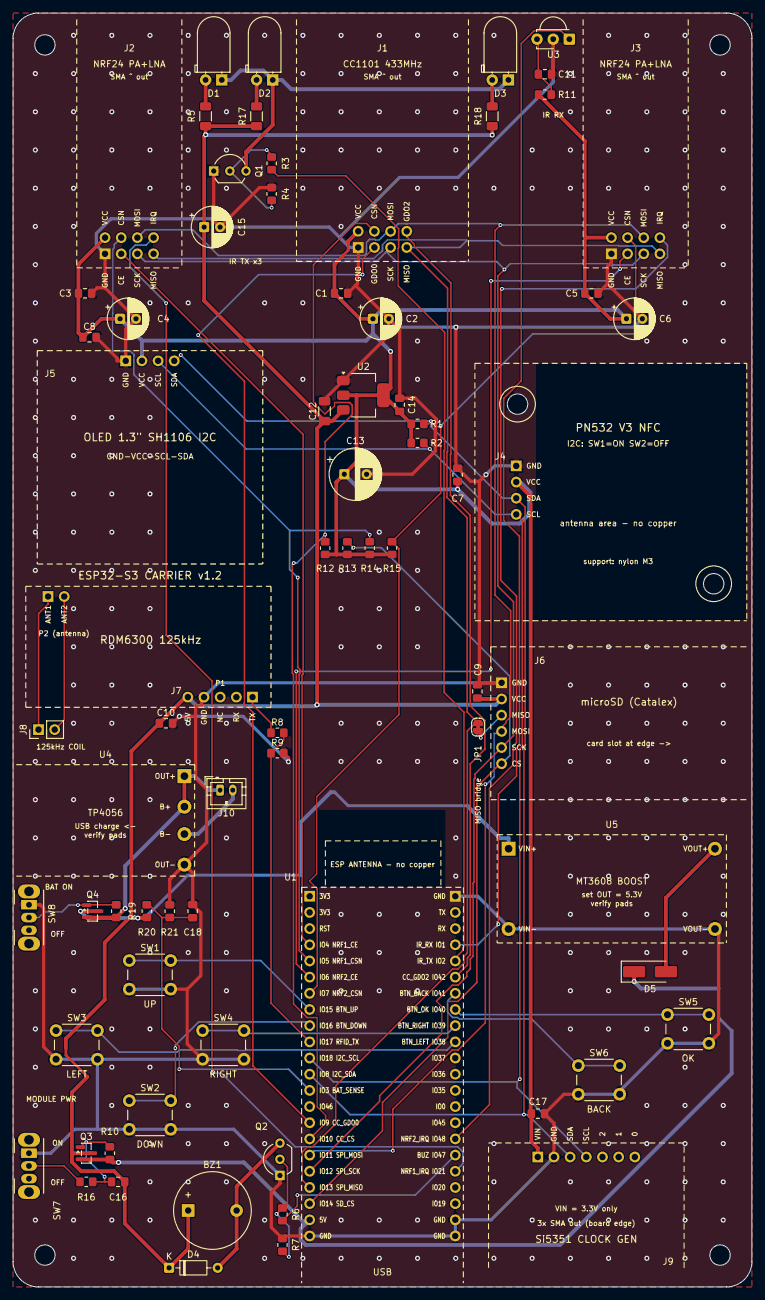
[picture p10: board ESP32S3_Carrier.kicad_pcb from above]

Board: 2 copper layers, 116.0 x 200.0 mm, 77 parts (0 on the bottom side), 49 nets.

Other parts of the board:
H1, H2, H3, H4: M3; MountingHole_3.2mm_M3
