Yoursel71/ESP32S3_Carrier/(commit log)

2026-10-22 ESP32-S3 taşıyıcı kart v1.0 (KiCad 10)
    ESP32-S3-DevKitC-1 N16R8 tabanlı 2 katmanlı taşıyıcı PCB: CC1101,
    2x NRF24L01+PA+LNA, PN532 V3 (I2C), RDM6300, Catalex microSD,
    1.3" SH1106 OLED, IR alıcı/verici, buzzer, 6 buton ve modül güç anahtarı.
    - Şema ve PCB tek kaynaktan (scripts/tasarim.py) üretilir
    - ERC 0/0, DRC 0 ihlal (şema uyumu dahil), %100 yönlendirme (Freerouting)
    - Render, 1:1 montaj PDF'i, Gerber, BOM cikti/ altında
    Claude-Session: https://claude.ai/code/session_01M7B8FMVeVb1bqPRBZwSV29
    [BOM.csv, ESP32S3_Tasiyici.kicad_pcb, ESP32S3_Tasiyici.kicad_sch, _rota.dsn]
2026-10-22 Rev 1.1: English, Si5351, 3 IR LEDs, soft-start, 3D board explorer
    - Everything renamed/translated to English (project ESP32S3_Carrier, library Carrier)
    - CC1101 moved to the top centre; Si5351 (3x SMA) added on I2C, bottom right
    - Three IR LEDs with individual 33R resistors + 100uF reservoir
    - IR receiver turned to face the board edge, RC supply filter added
    - Module power switch now soft-starts (fixes ESP32 reset from inrush)
    - 10k pull-ups on all SPI chip selects; GDO2 and NRF24 IRQs wired to free GPIOs
    - Board 116x170 mm; ERC 0/0, DRC 0 (schematic parity), 100% routed
    - output/board_explorer.html: interactive 3D view with layer toggles and net tracing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
    [BOM.csv, ESP32S3_Carrier.kicad_pcb, ESP32S3_Carrier.kicad_sch, ESP32S3_Tasiyici.kicad_pcb, ESP32S3_Tasiyici.kicad_sch, _rota.dsn, _route.dsn]
2026-10-22 IR LED resistors 33R -> 47R, README notes
    - 47R per IR LED (~67 mA, ~0.21 W) so a stuck-high IO2 stays inside the 1206 rating
    - README: drive IO2 only with the 38 kHz carrier; how to handle starved_thermal after a re-route
    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
    [BOM.csv, ESP32S3_Carrier.kicad_pcb, ESP32S3_Carrier.kicad_sch, _route.dsn]
2026-10-22 Si5351: match the real 7-pin module (30.7x21.6 mm)
    - 1x7 socket: 0, 1, 2, SCL, SDA, GND, VIN (VIN square pad), header 2.2 mm from the edge, centred
    - Only SCL/SDA/GND/VIN connected; VIN on +3V3_MOD (module level shifter pulls I2C to VIN)
    - CC1101 2x4 orientation confirmed by the owner
    - Re-routed: ERC 0/0, DRC 0 (schematic parity), 277 stitching vias
    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
    [ESP32S3_Carrier.kicad_pcb, ESP32S3_Carrier.kicad_sch, _route.dsn]
2026-10-22 Rev 1.2: 18650 battery power (TP4056 + MT3608 + main switch)
    - JST-PH 18650 connector, protected TP4056 charger at the left edge
    - Main power switch (SW8 + AO3401A), MT3608 boost to 5.3 V, SS34 diode-OR with DevKit USB
    - Battery voltage divider on IO3
    - Board 116x200 mm; ERC 0/0, DRC 0 (schematic parity), 100% routed
    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
    [BOM.csv, ESP32S3_Carrier.kicad_pcb, ESP32S3_Carrier.kicad_sch, _route.dsn]
